NicksonYap/XXD-HW30A-ESC-Schematic/schematic/HW30A.sch

## EAGLE design schematic/HW30A.sch (2016-06-25)

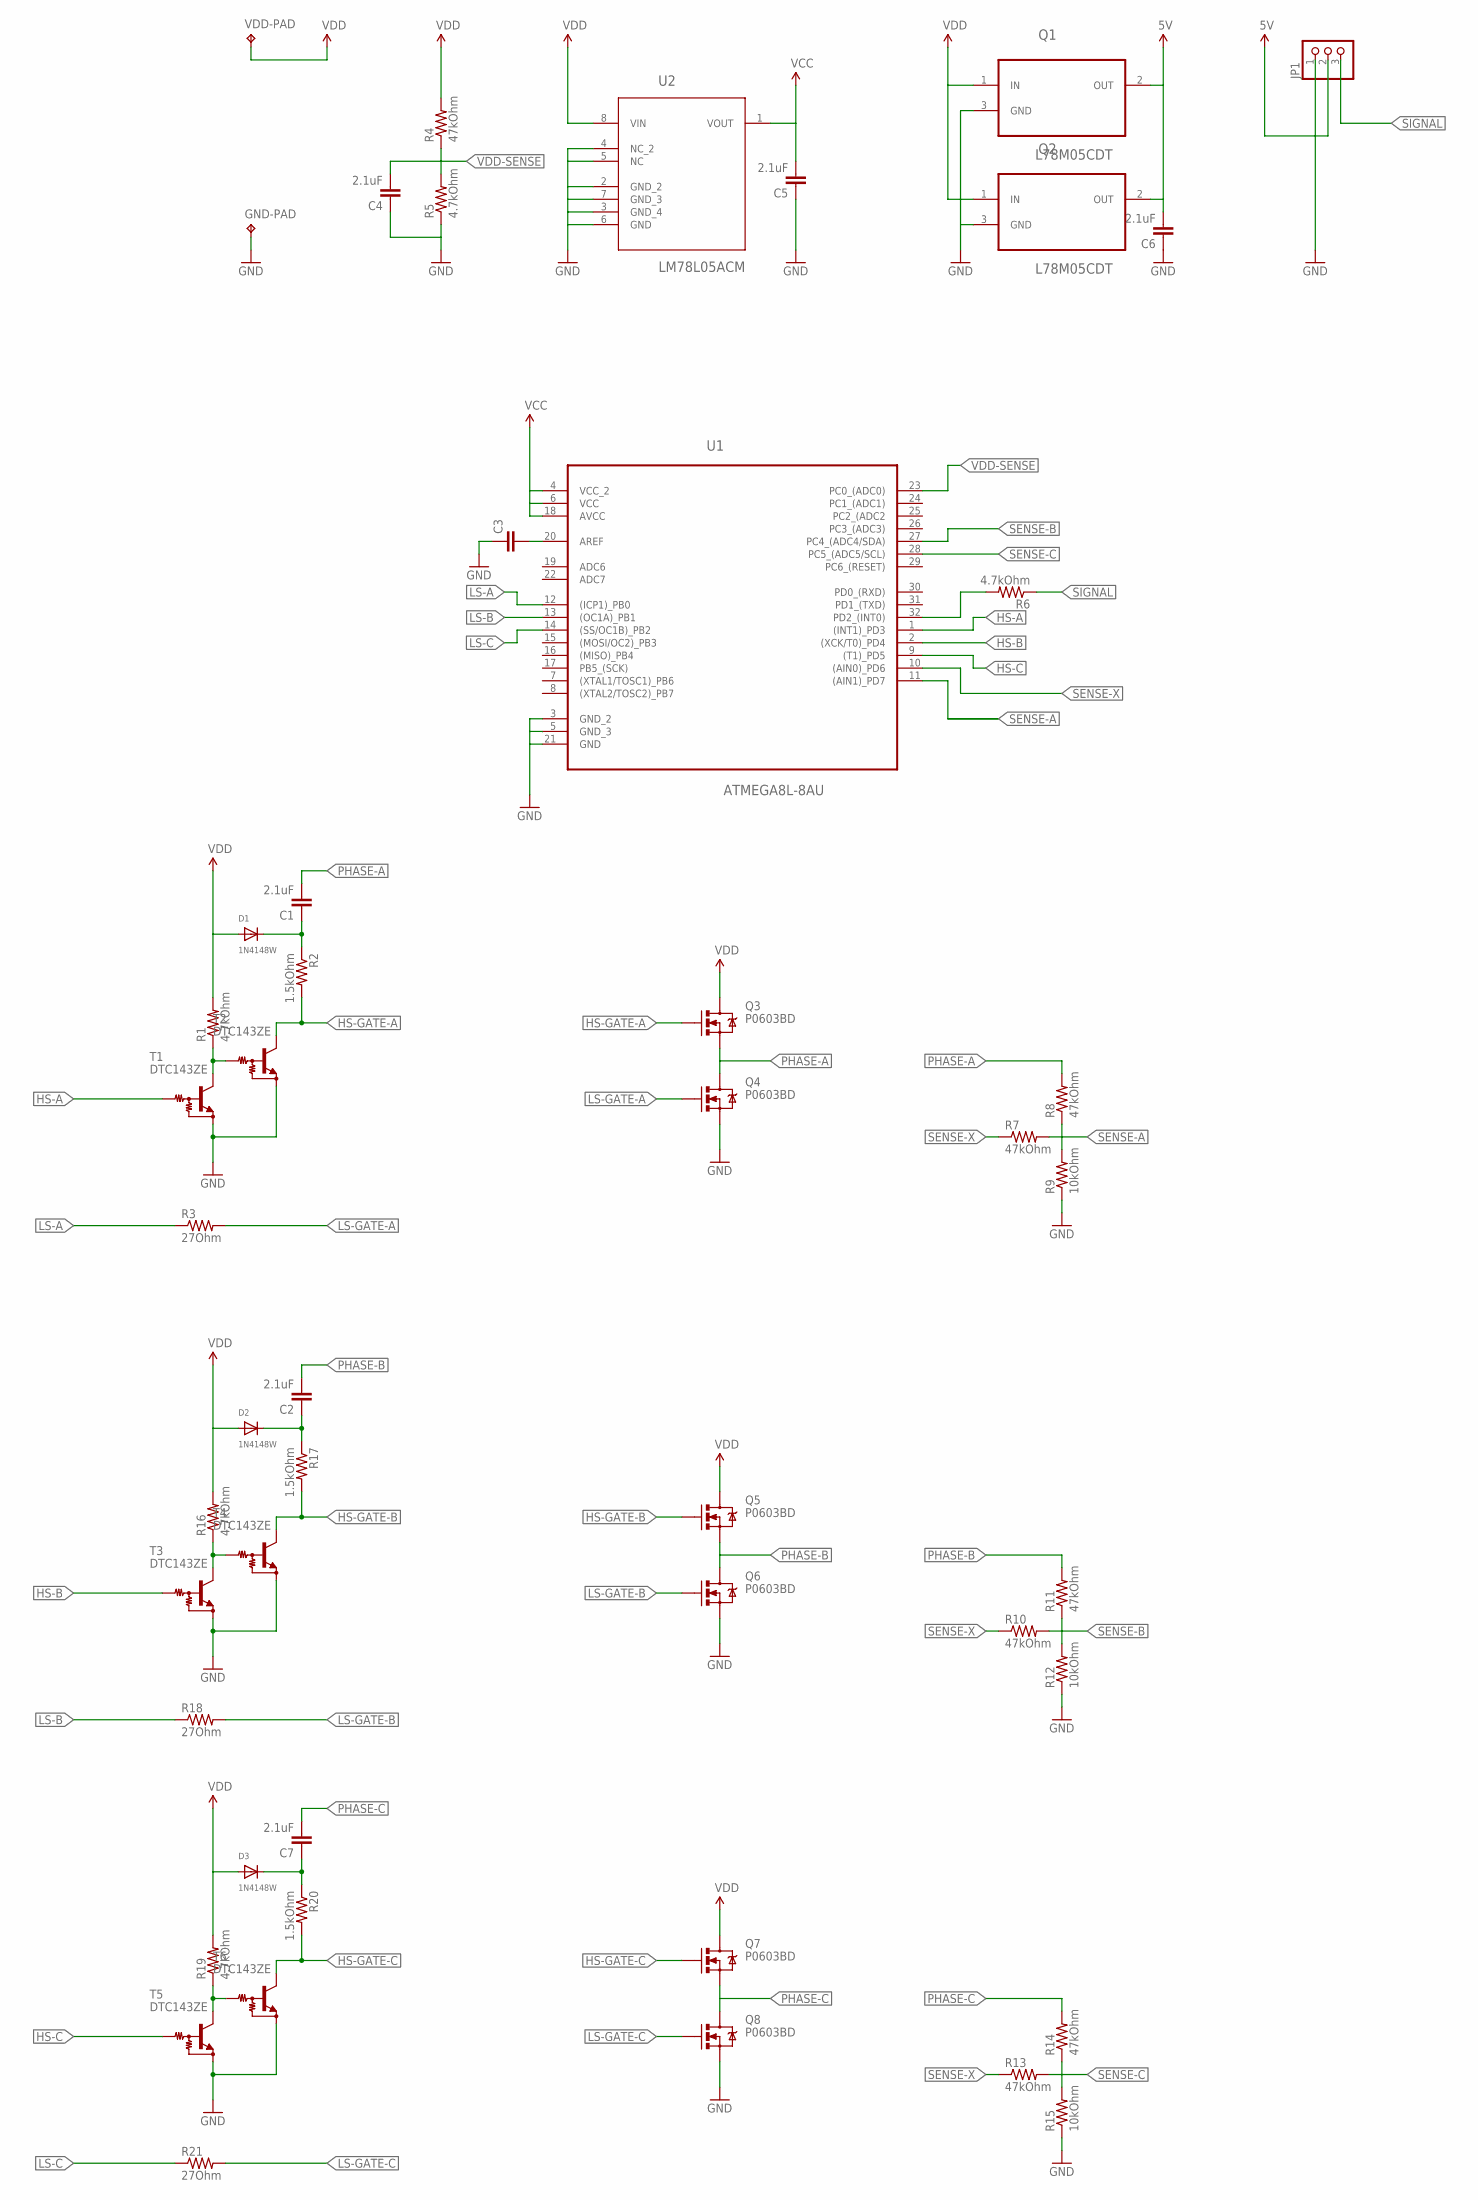
[picture p5: schematic HW30A.sch]

Parts:
C1, C2, C4, C5, C6, C7: 2.1uF; C0805K
C3: C-EUC0603K; C0603K
D1, D2, D3: 1N4148W; SOD-123
GND-PAD: TPTP20R; TP20R
JP1: PINHD-1X3CB; 1X03-CLEANBIG
Q1, Q2: L78M05CDT; TO225P972X240-3N
Q3, Q4, Q5, Q6, Q7, Q8: P0603BD; DPAK
R1, R5, R6, R16, R19: 4.7kOhm; R0603
R2, R17, R20: 1.5kOhm; R0805
R3, R18, R21: 27Ohm; R0603
R4, R7, R8, R10, R11, R13, R14: 47kOhm; R0603
R9, R12, R15: 10kOhm; R0603
T1, T2, T3, T4, T5, T6: DTC143ZE; SC59-BEC
U1: ATMEGA8L-8AU; QFP80P900X900X120-32N
U2: LM78L05ACM; SOIC127P620X175-8N
VDD-PAD: TPTP20R; TP20R

Connections:
5V: C6.2, JP1.2, Q1.2 (OUT), Q2.2 (OUT)
GND: C3.1, C4.1, C5.1, C6.1, GND-PAD.TP, JP1.1, Q1.3 (GND), Q2.3 (GND), Q4.3 (S), Q6.3 (S), Q8.3 (S), R5.1, R9.1, R12.1, R15.1, T1.E, T2.E, T3.E, T4.E, T5.E, T6.E, U1.3 (GND_2), U1.5 (GND_3), U1.21 (GND), U2.2 (GND_2), U2.3 (GND_4), U2.4 (NC_2), U2.5 (NC), U2.6 (GND), U2.7 (GND_3)
HS-A: T1.B, U1.1 ((INT1)_PD3)
HS-B: T3.B, U1.2 ((XCK/T0)_PD4)
HS-C: T5.B, U1.9 ((T1)_PD5)
HS-GATE-A: Q3.1 (G), R2.2, T2.C
HS-GATE-B: Q5.1 (G), R17.2, T4.C
HS-GATE-C: Q7.1 (G), R20.2, T6.C
LS-A: R3.1, U1.12 ((ICP1)_PB0)
LS-B: R18.1, U1.13 ((OC1A)_PB1)
LS-C: R21.1, U1.14 ((SS/OC1B)_PB2)
LS-GATE-A: Q4.1 (G), R3.2
LS-GATE-B: Q6.1 (G), R18.2
LS-GATE-C: Q8.1 (G), R21.2
unnamed: R1.1, T1.C, T2.B
unnamed: C1.1, D1.C, R2.1
unnamed: R16.1, T3.C, T4.B
unnamed: C3.2, U1.20 (AREF)
unnamed: C2.1, D2.C, R17.1
unnamed: R19.1, T5.C, T6.B
unnamed: C7.1, D3.C, R20.1
PHASE-A: C1.2, Q3.3 (S), Q4.4 (D), R8.2
PHASE-B: C2.2, Q5.3 (S), Q6.4 (D), R11.2
PHASE-C: C7.2, Q7.3 (S), Q8.4 (D), R14.2
SENSE-A: R7.2, R8.1, R9.2, U1.11 ((AIN1)_PD7)
SENSE-B: R10.2, R11.1, R12.2, U1.27 (PC4_(ADC4/SDA))
SENSE-C: R13.2, R14.1, R15.2, U1.28 (PC5_(ADC5/SCL))
SENSE-X: R7.1, R10.1, R13.1, U1.10 ((AIN0)_PD6)
SIGNAL: JP1.3, R6.2, U1.32 (PD2_(INT0))
VCC: C5.2, U1.4 (VCC_2), U1.6 (VCC), U1.18 (AVCC), U2.1 (VOUT)
VDD: D1.A, D2.A, D3.A, Q1.1 (IN), Q2.1 (IN), Q3.4 (D), Q5.4 (D), Q7.4 (D), R1.2, R4.2, R16.2, R19.2, U2.8 (VIN), VDD-PAD.TP
VDD-SENSE: C4.2, R4.1, R5.2, U1.23 (PC0_(ADC0))
