NicksonYap/XXD-HW30A-ESC-Schematic/(threads)

Thread 2 (2021-12-31):

How PWM signal generated on PB0?

Menginventor, 2021-12-31:
The "LS-A" has connected to pin PB0 which not PWM output pin. How your firmware manage to use it as PWM?

RoyTheReaper, 2022-09-19:
> The "LS-A" has connected to pin PB0 which not PWM output pin. How your firmware manage to use it as PWM?

If I had to guess, the low sides are ON/OFF and only the high side fets (with the driver transistors) are pwm controlled.
