NicksonYap/XXD-HW30A-ESC-Schematic/(commit log)

2016-06-25 add voltage regulator datasheet, rename transistor datasheet
2016-06-25 add readme and schematic image
2016-06-25 added ESC switching performance
2016-06-26 added memory dump files and fuse info in readme
2016-06-26 add fuse decription
